guilhermesv/eletrotramas-labquilombola/codigo-openlab/Instalacao-Padroes/Instalacao-Padroes.ino

#include <FastLED.h>

// CONFIGURACAO ESP
#define VOLTS       5
#define MILIAMPS    8000    

// CONFIGURACAO FITA
#define LED_PIN     4   
#define BAR_LEDS    48
#define NUM_LEDS    864 // 864
#define RUIDO_BRILHO     5
CRGB leds[NUM_LEDS];

// CONFIGURACAO AUDIO
#define MIC_PIN     34
#define A_SAMPLES   256 // Número de amostras para analisar amplitude
#define RUIDO   400
#define FAIXA_A 1000
#define FAIXA_B 1200
#define FAIXA_C 1800

// CONFIGURACAO PADROES
#define PADROES_QTD     18
#define PADRAO_LIN_QTD  24
#define PADRAO_COL_QTD  24
#define REGRAS_QTD      4
#define REGRAS_TAM      12;
uint8_t p_A = 0; // padrão selecionado
uint8_t p_B = 4; // padrão selecionado
uint8_t p_C = 9; // padrão selecionado
int p_A_sentido = 1;
int p_B_sentido = 1;
int p_C_sentido = 1;
uint8_t r = 0; // regra selecionada

// CONFIGURACAO PALETAS
uint8_t cor = 0;
DEFINE_GRADIENT_PALETTE(r_g_b){
  0  , 255,   0,   0,
  85 ,   0, 255,   0,
  170,   0,   0, 255,
  255, 255,   0,   0,
};
CRGBPalette16 pal_faixa_A = r_g_b;

DEFINE_GRADIENT_PALETTE(b_r_g){
  0  ,   0,   0, 255,
  85 , 255,   0,   0,
  170,   0, 255,   0,
  255,   0,   0, 255,
};
CRGBPalette16 pal_faixa_B = b_r_g;
uint8_t cor_faixa_B = 80;

DEFINE_GRADIENT_PALETTE(g_b_r){
  0  ,   0, 255,   0,
  85 ,   0,   0, 255,
  170, 255,   0,   0,
  255,   0, 255,   0,
};
CRGBPalette16 pal_faixa_C = g_b_r;
uint8_t cor_faixa_C = 120;

// GLOBAIS AUXILIARES
int t = 0;

// REGRAS

const char* regras[4] = {
"111111111111",
};

// PADROES

const char* padroes[PADROES_QTD][PADRAO_COL_QTD] = {
{
"1-----1-----1-----1-----",
"11----11----11----11----",
"111---111---111---111---",
"1111--1111--1111--1111--",
"-1111--1111--1111--1111-",
"--1111--1111--1111--1111",
"---111---111---111---111",
"----11----11----11----11",
"-----1-----1-----1-----1",
"------------------------",
"------------------------",
"------------------------",
"------------------------",
"-1-----1-----1-----1----",
"-11----11----11----11---",
"-111---111---111---111--",
"-1111--1111--1111--1111-",
"--1111--1111--1111--1111",
"---111---111---111---111",
"----11----11----11----11",
"-----1-----1-----1-----1",
"------------------------",
"------------------------",
"------------------------",  
},
{
"1------------1----------",
"111----------111--------",
"111111-------111111-----",
"111111111----111111111--",
"--1111111111--1111111111",
"---111111111---111111111",
"------111111------111111",
"---------111---------111",
"-----------1-----------1",
"------------------------",
"------------------------",
"------------------------",
"1------------1----------",
"111----------111--------",
"111111-------111111-----",
"111111111----111111111--",
"--1111111111--1111111111",
"---111111111---111111111",
"------111111------111111",
"---------111---------111",
"-----------1-----------1",
"------------------------",
"------------------------",
"------------------------",  
},
{
"1-----------------------",
"11----------------------",
"111---------------------",
"1111--------------------",
"11111-------------------",
"111111------------------",
"1111111-----------------",
"11111111----------------",
"111111111---------------",
"1111111111--------------",
"11111111111-------------",
"111111111111------------",
"1111111111111-----------",
"-------------1----------",
"-------------11---------",
"-------------111--------",
"-------------1111-------",
"-------------11111------",
"-------------111111-----",
"-------------1111111----",
"-------------11111111---",
"-------------111111111--",
"-------------1111111111-",
"-------------11111111111",
},
{
"111111111111111111111111",
"-1111111111111111111111-",
"--11111111111111111111--",
"---111111111111111111---",
"----1111111111111111----",
"-----11111111111111-----",
"------111111111111------",
"-------1111111111-------",
"--------11111111--------",
"---------111111---------",
"----------1111----------",
"-----------11-----------",
"-----------11-----------",
"----------1111----------",
"---------111111---------",
"--------11111111--------",
"-------1111111111-------",
"------111111111111------",
"-----11111111111111-----",
"----1111111111111111----",
"---111111111111111111---",
"--11111111111111111111--",
"-1111111111111111111111-",
"111111111111111111111111",
},
{
"1-----------------------",
"11----------------------",
"111---------------------",
"1111--------------------",
"11111-------------------",
"111111------------------",
"1111111-----------------",
"11111111----------------",
"111111111---------------",
"1111111111--------------",
"11111111111-------------",
"111111111111------------",
"111111111111111111111111",
"-------------11111111111",
"--------------1111111111",
"---------------111111111",
"----------------11111111",
"-----------------1111111",
"------------------111111",
"-------------------11111",
"--------------------1111",
"---------------------111",
"----------------------11",
"-----------------------1",
},
{
"111111111111------------",
"111111111111------------",
"111111111111------------",
"111111111111------------",
"111111111111------------",
"111111111111------------",
"111111111111------------",
"111111111111------------",
"111111111111------------",
"111111111111------------",
"111111111111------------",
"111111111111------------",
"------------111111111111",
"------------111111111111",
"------------111111111111",
"------------111111111111",
"------------111111111111",
"------------111111111111",
"------------111111111111",
"------------111111111111",
"------------111111111111",
"------------111111111111",
"------------111111111111",
"------------111111111111",
},
{ 
"11----------------------",
"1111--------------------",
"111111------------------",
"11111111----------------",
"1111111111--------------",
"111111111111------------",
"11111111111111----------",
"1111111111111111--------",
"111111111111111111------",
"11111111111111111111----",
"1111111111111111111111--",
"111111111111111111111111",
"--1111111111111111111111",
"----11111111111111111111",
"------111111111111111111",
"--------1111111111111111",
"----------11111111111111",
"------------111111111111",
"--------------1111111111",
"----------------11111111",
"------------------111111",
"--------------------1111",
"----------------------11",
"------------------------", 
},
{
"1111--------------------",
"11111111----------------",
"111111111111------------",
"1111111111111111--------",
"11111111111111111111----",
"111111111111111111111111",
"111111111111111111111111",
"111111111111111111111111",
"----11111111111111111111",
"--------1111111111111111",
"------------111111111111",
"----------------11111111",
"--------------------1111",
"------------------------",
"------------------------",
"------------------------",
"------------------------",
"------------------------",
"------------------------",
"------------------------",
"------------------------",
"------------------------",
"------------------------",
"------------------------",
},
{
"1-----------------------",
"11----------------------",
"111---------------------",
"1111--------------------",
"11111-------------------",
"111111------------------",
"1111111-----------------",
"11111111----------------",
"111111111---------------",
"1111111111--------------",
"11111111111-------------",
"111111111111------------",
"1111111111111-----------",
"11111111111111----------",
"111111111111111---------",
"1111111111111111--------",
"11111111111111111-------",
"111111111111111111------",
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
"------------------------",
},
{
"-----------11-----------",
"----------1--1----------",
"---------1----1---------",
"--------1------1--------",
"-------1--------1-------",
"------1----------1------",
"-----1-----11-----1-----",
"----1-----1--1-----1----",
"---1-----1----1-----1---",
"--1-----1------1-----1--",
"-1-----1--------1-----1-",
"1-----1----------1-----1",
"1-----1----------1-----1",
"-1-----1--------1-----1-",
"--1-----1------1-----1--",
"---1-----1----1-----1---",
"----1-----1--1-----1----",
"-----1-----11-----1-----",
"------1----------1------",
"-------1--------1-------",
"--------1------1--------",
"---------1----1---------",
"----------1--1----------",
"-----------11-----------",
},
{
"1----------------------1",
"-1--------------------1-",
"--1------------------1--",
"---1----------------1---",
"----1--------------1----",
"-----1------------1-----",
"------1----------1------",
"-------1--------1-------",
"--------1------1--------",
"---------1----1---------",
"----------1--1----------",
"-----------11-----------",
"-----------11-----------",
"----------1--1----------",
"---------1----1---------",
"--------1------1--------",
"-------1--------1-------",
"------1----------1------",
"-----1------------1-----",
"----1--------------1----",
"---1----------------1---",
"--1------------------1--",
"-1--------------------1-",
"1----------------------1",
},
{
"---------111111---------",
"-------11------11-------",
"------1----11----1------",
"-----1----1--1----1-----",
"----1----1----1----1----",
"---1----1------1----1---",
"--1----1--------1----1--",
"-1----1----------1----1-",
"-1----1----------1----1-",
"1----1------------1----1",
"1----1------------1----1",
"1----1------------1----1",
"1----1------------1----1",
"1----1------------1----1",
"1----1------------1----1",
"-1----1----------1----1-",
"-1----1----------1----1-",
"--1----1--------1----1--",
"---1----1------1----1---",
"----1----1----1----1----",
"-----1----1--1----1-----",
"------1----11----1------",
"-------11------11-------",
"---------111111---------",
},
};


void processa_faixa(uint8_t p, CRGB cor, int sentido) {
  for (int j = 0; j < NUM_LEDS; j += BAR_LEDS) {
    int barra_offset = j / BAR_LEDS;
    bool reverso = barra_offset % 2;
    int padrao_linha = (barra_offset + t * sentido) % PADRAO_LIN_QTD;
    for (int i = 0; i < BAR_LEDS; i++) {
      int led_indice = reverso ? (j + BAR_LEDS - 1) - i : j + i;
      int padrao_coluna = (i) % PADRAO_COL_QTD;
      if (padroes[p][padrao_linha][padrao_coluna] == regras[0][0]) {
        leds[led_indice] = cor;
      }
    }
  }
}
