guilhermesv/eletrotramas-labquilombola/codigo-openlab/Teste-Padrao-Binario-2/Teste-Padrao-Binario-2.ino

#include <FastLED.h>

// Definições
#define LED_PIN     4
#define NUM_LEDS    1200
#define BRIGHTNESS  64
#define LED_TYPE    WS2812
#define COLOR_ORDER GRB

CRGB leds[NUM_LEDS];

// Padrão binário
#define PADROES_QTD     7
#define PADRAO_LIN_QTD  16
#define PADRAO_COL_QTD  16

char* padroes[PADROES_QTD][PADRAO_COL_QTD] = {
{
  "1111000011110000",
  "0000111100001111",
  "1111000011111111",
  "0000111100000000",
  "1111000011110000",
  "0000111100001111",
  "1111111100000000",
  "0000000011110000",
  "0000000000001111",
  "1111111100000000",
  "0000000011110000",
  "0000000000001111",
  "1111000011110000",
  "0000111100001111",
  "1111000000000000",
  "0000111100001111"
},
{
  "1000000000000000",
  "0100000000000000",
  "0010000000000000",
  "0001000000000000",
  "0000100000000000",
  "0000010000000000",
  "0000001000000000",
  "0000000100000000",
  "0000000010000000",
  "0000000001000000",
  "0000000000100000",
  "0000000000010000",
  "0000000000001000",
  "0000000000000100",
  "0000000000000010",
  "0000000000000001",
},
{
  "1100000000000000",
  "1111000000000000",
  "0011110000000000",
  "0000111100000000",
  "0000001111000000",
  "0000000011110000",
  "0000000000111100",
  "0000000000001111",
  "0000000000000011",
  "0000000000001111",
  "0000000000111100",
  "0000000011110000",
  "0000001111000000",
  "0000111100000000",
  "0011110000000000",
  "1111000000000000"
},
{
  "1111111111111111",
  "0011111111111100",
  "0000111111110000",
  "0000001111000000",
  "0000000110000000",
  "0000000000000000",
  "0000000000000000",
  "0000000000000000",
  "1111111111111111",
  "0011111111111100",
  "0000111111100000",
  "0000001111000000",
  "0000000110000000",
  "0000000000000000",
  "0000000000000000",
  "0000000000000000"
},
{
  "1111111100000000",
  "0000000011111111",
  "1111000011110000",
  "0000111100001111",
  "1100110011001100",
  "0011001100110011",
  "1010101010101010",
  "0101010101010101",
  "1111111100000000",
  "0000000011111111",
  "1111000011110000",
  "0000111100001111",
  "1100110011001100",
  "0011001100110011",
  "1010101010101010",
  "0101010101010101"
},
{
"1111111111111111",
"0000000000000000",
"1110111011101110",
"0000000000000000",
"0110011001100110",
"0000000000000000",
"0100010001000100",
"0000000000000000",
"0000000000000000",
"0000000000000000",
"0000000000000000",
"0010001000100010",
"0000000000000000",
"1100110011001100",
"0000000000000000",
"0111011101110111"
},
{
"0000000110000000",
"0000000000000000",
"0000011001100000",
"0000000000000000",
"0001100000011000",
"0000000000000000",
"0111111001111110",
"0000000000000000",
"1111111111111111",
"0000000000000000",
"0111111001111110",
"0000000000000000",
"0001100000011000",
"0000000000000000",
"0000011001100000",
"0000000000000000"
}
};

#define REGRAS_QTD  4
uint8_t regra = 0;
char* regras[4] = {
  "11111111",
  "11--11--",
  "1111----",
  "----1111"
};

int t = NUM_LEDS * 4;
int s = 0;
int hue_offset = 0;

void setup() {
  // Inicializa a fita de LED
  FastLED.addLeds<WS2812, LED_PIN, GRB>(leds, NUM_LEDS);
  FastLED.clear();
  FastLED.setBrightness(BRIGHTNESS);
  s = random8(PADROES_QTD); // Alterna ente os padrões de tempo em tempo
  hue_offset = random(127);
  regra = random8(REGRAS_QTD);
  
  // Serial.begin(115200);
  // Serial.print(s, regra, hue_offset);
  // Serial.println("--------");

}

void loop() {
  // Repete o padrão ao longo da fita de LED
  int barra_offset = 0;
  for (int i = 0; i < NUM_LEDS; i++) {
    if(i % 48 == 0) {
      barra_offset++;
    }
    int padrao_coluna = i % PADRAO_COL_QTD;
    int padrao_linha = (barra_offset + t) % PADRAO_LIN_QTD;
    if (padroes[s][padrao_linha][padrao_coluna] == regras[regra][padrao_coluna] ) {
      // leds[i] = CRGB::Red;
      leds[i] = CHSV(hue_offset, 255, 255);
    }
  }

  EVERY_N_MILLISECONDS(20) {
    fadeToBlackBy(leds, NUM_LEDS, 100);
  }

  EVERY_N_MILLISECONDS(200) {
    t++;
  }

  EVERY_N_MILLISECONDS(5000) {
    s = random8(PADROES_QTD);
    regra = random8(REGRAS_QTD);
  }

  EVERY_N_SECONDS(30) {
    hue_offset = (hue_offset + 1) % 255;
  }

  FastLED.show();
  
}
