guilhermesv/eletrotramas-labquilombola/(commit log)

2025-07-05 Inserção de controle de voltagem
2025-07-20 Estudos de padrões binários
2025-07-26 Testes manipulando os leds por faixa de amplitude
2025-08-02 Correção na maneira de atualizar o brilho.
    Código anterior utilizava a função fadeToBlackBy(), que é referente a todos a array de leds, mas não atualizava o fade na array de brilho.
2025-08-02 Update Teste-Microfone-Selecao-AdicionarBrilho.ino
    Correção "adicionar brilho" e inserção de controle individual do tom também. Ajustes pra reduzir atualizações com frequencia muito alta da fita que causando flickring.
2025-08-10 Atualização de padrões, correção de bugs e novas lógicas de funcionamento
    [Instalacao-Padroes.ino, main.ino]
2025-08-12 Inicio debug passagem de cor
2025-08-16 Numero de leds da instalação final
2025-08-16 Consolidação do processamento das faixas de som.
2025-08-16 Vários ajustes
    - Otimização do código
    - Aumento forçado de velocidade
2025-08-17 Implementação paleta e reduções de padrões
2025-08-18 Inserção de uma animação pra ruído
    Evitar que as fitas fiquem totalmente apagadas
2025-08-19 Inserção de alternância de sentido
2025-08-20 Rotina de inicialização
